iCShopMgr/Linkit7697_AirBox/README.md

# Linkit769 AirBox
* 組裝教學PDF
* LinkIt_AirBox是Arduino IDE編寫的示範程式
